szymek325/EngineeringDegree/README.md

# Engineering Degree project
Smart crontrol of temperature in room with Arduino and mobile app

## Modules:
### Mobile app- Ionic(AngularJS)
* temperature control
* display of historic data
* Bluetooth connection to regulator

### Regulator- Arduino
* temperature regulation accordingly to parameters set from Mobile App

### Documentation- LateX
