szymek325/EngineeringDegree/Documentation/Mateusz_Szymkowiak_Praca_Dyplomowa_Inzynierska.tex

\documentclass[11pt, a4paper,polish,twoside]{report}
\usepackage{graphicx}
\usepackage{times}
\usepackage[T1]{fontenc}
\usepackage[polish]{babel}
\usepackage[utf8]{inputenc}
\usepackage{lmodern}
\usepackage{hyperref}
\usepackage{graphicx}
\usepackage{pdfpages}
\usepackage{mathtools}
\selectlanguage{polish}
\usepackage{indentfirst}
\usepackage{gensymb}
\usepackage{rotating}
\widowpenalty=10000
\pagestyle {plain}
\usepackage{float}
\usepackage{geometry}
\usepackage{mathptmx}
\newgeometry{tmargin=2.5cm, bmargin=3.0cm, left=3.5cm, right=2.5cm}
\setcounter{secnumdepth}{2}
\linespread{1.3}
\usepackage{etoolbox}
\patchcmd{\chapter}{\thispagestyle{plain}}{\thispagestyle{fancy}}{}{}
\setlength{\headsep}{1.5cm}
\usepackage{listings}
\usepackage{lastpage}
\usepackage[MeX]{polski}
\graphicspath{ {./pictures/} }
\newcommand{\HRule}{\rule{\linewidth}{0.5mm}}
\usepackage{fancyhdr}
\pagestyle{fancy}
\setcounter{tocdepth}{1}
\usepackage[backend=bibtex]{biblatex}
\bibliography{bibliografia.bib}

\lstdefinelanguage{JavaScript}{
  keywords={typeof, new, true, false, catch, function, return, null, catch, switch, var, if, in, while, do, else, case, break},
  keywordstyle=\color{blue}\bfseries,
  ndkeywords={class, export, boolean, throw, implements, import, this},
  ndkeywordstyle=\color{darkgray}\bfseries,
  identifierstyle=\color{black},
  sensitive=false,
  comment=[l]{//},
  morecomment=[s]{/*}{*/},
  commentstyle=\color{purple}\ttfamily,
  stringstyle=\color{red}\ttfamily,
  morestring=[b]',
  morestring=[b]"
}

\begin{document}

%%%%%%%%%%%%%%%%%%%%%%%%		STRONA TYTUŁOWA

\input{sections/stronaTytulowa.tex}

%%%%%%%%%%%%%%%%%%%%%%%%		
\newpage
\null
\thispagestyle{empty}
\newpage
\includepdf[pages={1}]{./pictures/karta_pracy.pdf}

%%%%%%%%%%%%%%%%%%%%%%%%		STRESZCZENIE
\input{sections/streszczenie.tex}
%%%%%%%%%%%%%%%%%%%%%%%%		SPIS TREŚCI

\tableofcontents

%%%%%%%%%%%%%%%%%%%%%%%%	WSTĘP     \\\\\\\\\OK
\chapter{Wstęp}
\input{sections/wstep.tex}

%%%%%%%%%%%%%%%%%%%%%%%%	CEL I ZAKRES PRAC  \\\\\\OK
\chapter{Cel i zakres prac}
\input{sections/celiZakresPrac.tex}

%%%%%%%%%%%%%%%%%%%%%%%%	PODSTAWY TEORETYCZNE  \\\\\\OK
\chapter{Podstawy teoretyczne}
\input{sections/podstawyTeoretyczne.tex}

%%%%%%%%%%%%%%%%%%%%%%%%	Część konstrukcyjna  \\\\\\wygląda ok \\ZMIEN ZDJECIA
\chapter{Konstrukcja obiektu i układu regulacji}
\input{sections/czescKonstrukcyjna.tex}

%%%%%%%%%%%%%%%%%%%%%%%%	Arduino \\\w trakcie
\chapter{Sterowanie układem regulacji temperatury- Arduino}
\input{sections/arduino.tex}

%%%%%%%%%%%%%%%%%%%%%%%%	Aplikacja mobilna
\chapter{Aplikacja mobilna}
\input{sections/aplikacjaMobilna.tex}

%%%%%%%%%%%%%%%%%%%%%%%%	Testy działania
\chapter{Przeprowadzone testy}
\input{sections/regulacjaTemperatury.tex}

%%%%%%%%%%%%%%%%%%%%%%%%	Podsumowanie
\chapter{Podsumowanie}
\input{sections/podsumowanie.tex}

%%%%%%%%%%%%%%%%%%%%%%%%		BIBLIOGRAFIA
\addcontentsline{toc}{chapter}{Bibliografia}
%\input{sections/bibliografia.tex}

\nocite{*}
\printbibliography 

%%%%%%%%%%%%%%%%%%%%%%%%		Dodatki
\chapter*{Dodatki}
\addcontentsline{toc}{chapter}{Dodatki}
Dodatek do niniejszej pracy stanowi płyta CD zawierająca:
\begin{itemize}
\item pracę dyplomową w postaci źródłowej (LaTeX),
\item pracę dyplomową w postaci pliku pdf,
\item program napisany w Arduino IDE,
\item pliki źródłowe aplikacji mobilnej,
\item aplikację w postaci paczki dystrybucyjnej app.
\end{itemize}

\newpage
\addcontentsline{toc}{section}{Spis rysunków}	
\listoffigures

\newpage
\addcontentsline{toc}{section}{Spis tablic}	
\listoftables

%%%%%%%%%%%%%%%%%%%%%%%%

\end{document}
