szymek325/EngineeringDegree/Documentation/sections/bibliografia.tex

\newpage
\begin{thebibliography}{99}
\bibitem{1}
\emph{Arduino Playground},
http://playground.arduino.cc/
\bibitem{seb} ktos:
\emph{tytul},
Wydawnictwo , Poznań 2000
\end{thebibliography}
