szymek325/EngineeringDegree/Documentation/sections/streszczenie.tex

\vspace*{\fill}
\begin{center}
{\centering \Huge \bfseries Streszczenie}\\
\end{center}
W pracy zaprezentowano układ regulacji temperatury oparty o urządzenie mikroprocesorowe, Arduino. Jako obiekt chłodzący oraz grzejący użyto ogniwa Peltiera. Odczyt aktualnych pomiarów odbywa się przez interfejs dedykowanej aplikacji. Dane zostają wyświetlone na wykresach.  Aplikacja umożliwia wybór temperatury zadanej, regulatora oraz nastaw. Ze względu na użycie jedynie jednego ogniwa, temperaturę regulowano w obiekcie małych rozmiarów.
\\
\\
\\
\begin{center}
 {\Huge \bfseries  Abstract}\\
\end{center}
This work presents a temperature control system based on Arduino system. Peltier's cell was used as cooling and heating object. Actual readings can be read with use of dedicated mobile app. Data is visualised on graphs. Application allows user to choose setpoint temperature, regulator and regulator settings. Due to use of only one cell, the temperature was controlled in object of small size.
\\
\\
\\
\\
\\
\\
\\
\\
\\
\vspace*{\fill}
