szymek325/EngineeringDegree/Documentation/sections/stronaTytulowa.tex

\begin{titlepage}
	\begin{center}
		\textsc{\LARGE Politechnika Poznańska}\\[0.3cm] 
		\textsc{\large Wydział Elektryczny}\\[0.3cm]
		\textsc{\large Instytut Automatyki i Inżynierii Informatycznej}\\[0.3cm]
		\textsc{\large Zakład Sterowania i Elektroniki Przemysłowej}\\[0.3cm]
		\begin{figure}[!ht]
		\centering
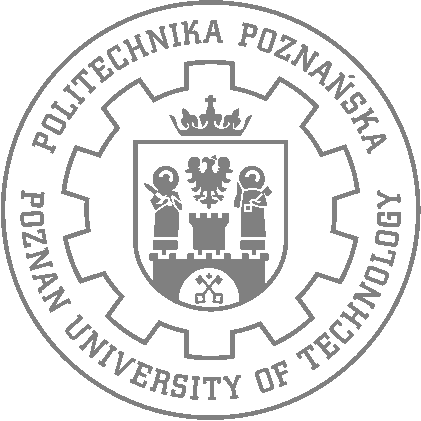
[picture p25: Documentation/pictures/logoPP.png]
		
		\end{figure}
		\textsc{\Large Praca inżynierska}\\[0.5cm]
		\HRule \\[0.4cm]
		{ \huge  Sterowanie wybranym procesem technologicznym za pomocą układu mikroprocesorowego\\[0.4cm] }
		\HRule \\[2.5cm]
		\noindent
		\begin{minipage}{0.4\textwidth}
			\begin{flushleft} 
				\large \emph{Autor:}\\ Mateusz Szymkowiak
			\end{flushleft}
		\end{minipage}%
		\begin{minipage}{0.4\textwidth}
			\begin{flushright} \large
				\emph{Promotor:} \\ \hfill dr hab. inż. 
				\\Tomasz Pajchrowski
				
			\end{flushright}
		\end{minipage}
		
		\vfill
		
		% Bottom of the page
		{\large \today}

	\end{center}

\end{titlepage}

\lhead{\scriptsize \textsc{Praca dyplomowa pt. ,,Sterowanie wybranym procesem technologicznym za pomocą układu mikroprocesorowego''\\
		Politechnika Poznańska, Instytut automatyki i inżynierii informatycznej\\
		Zakład Sterowania i Elektroniki Przemysłowej}}
\rhead{{\thepage{} z \pageref{LastPage}}}
