szymek325/EngineeringDegree/Documentation/sections/konfiguracja.tex

\section{Układ pomiarowo-wykonawczy}
W tym dziale przedstawiono 
\begin{figure}[H]
	\centering
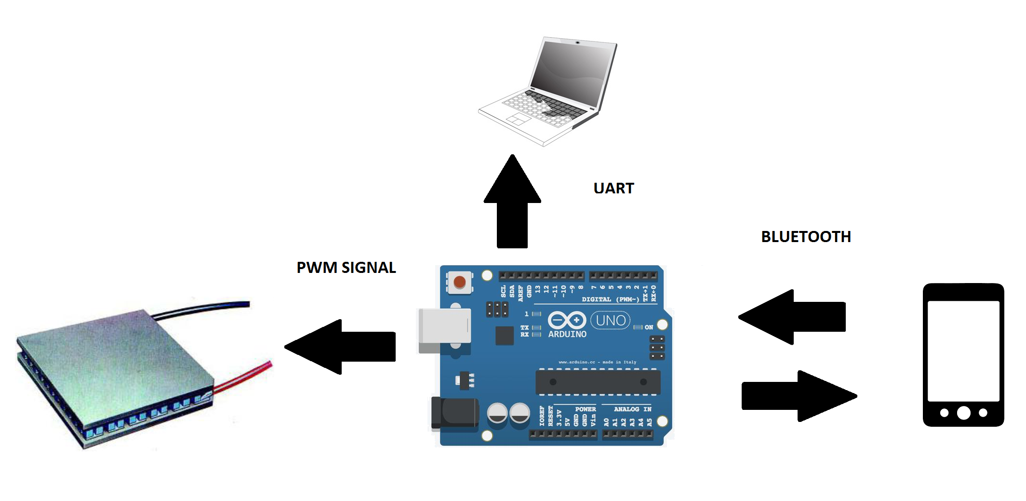
[picture p26: Documentation/pictures/schemat_komunikacji.png]
	
	\caption{Schemat połączeń komunikacyjnych}
\end{figure}
