szymek325/EngineeringDegree/Documentation/pictures/Bluetooth_ramka.png

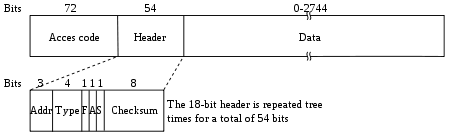
Documentation/pictures/Bluetooth_ramka.png
