szymek325/EngineeringDegree/Documentation/pictures/ogniwoPolaczenieRzeczywiste.jpg

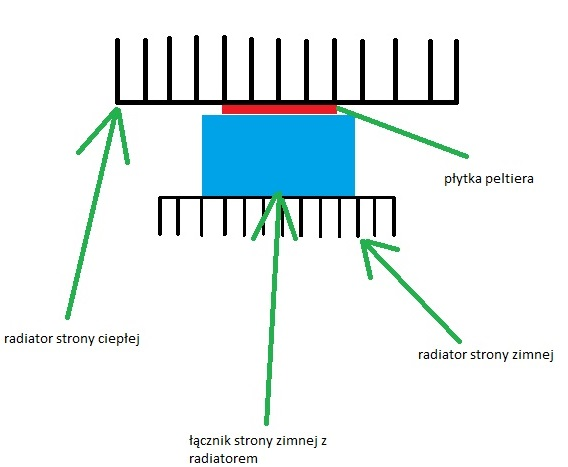
Documentation/pictures/ogniwoPolaczenieRzeczywiste.jpg
