szymek325/EngineeringDegree/Documentation/pictures/plytkaPolaczenia.jpg

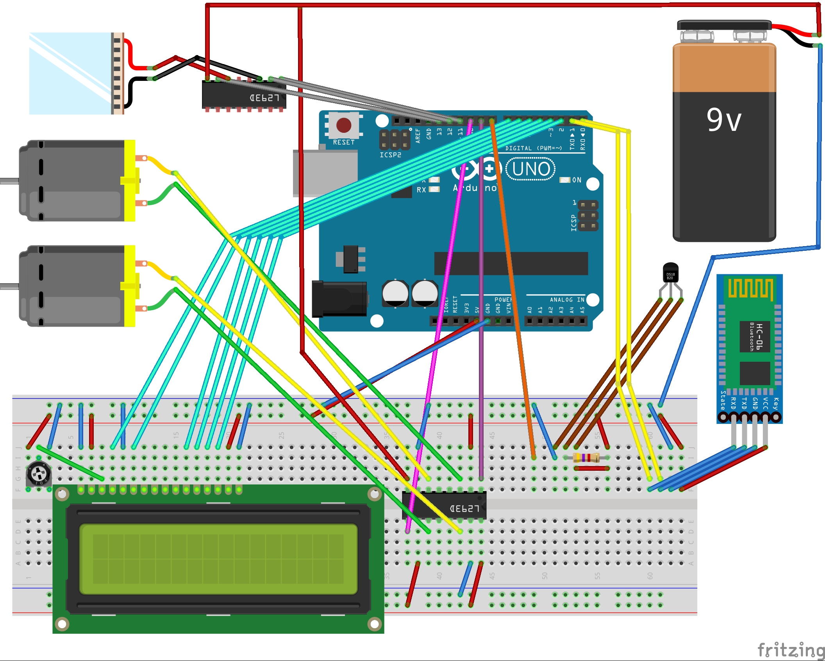
Documentation/pictures/plytkaPolaczenia.jpg
