szymek325/EngineeringDegree/Documentation/pictures/schemat_dzialania — kopia.png

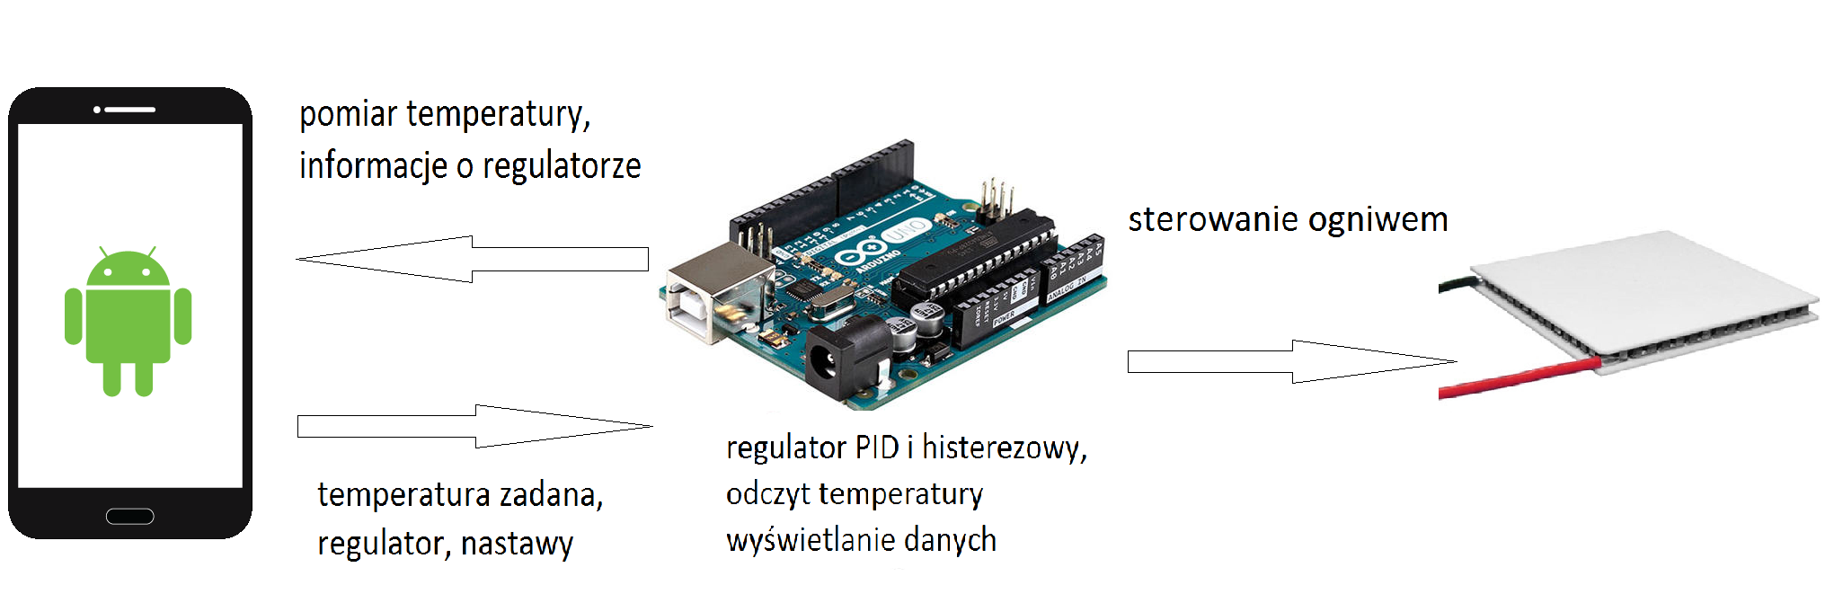
Documentation/pictures/schemat_dzialania — kopia.png
