szymek325/EngineeringDegree/Documentation/pictures/schematElektryczny.jpg

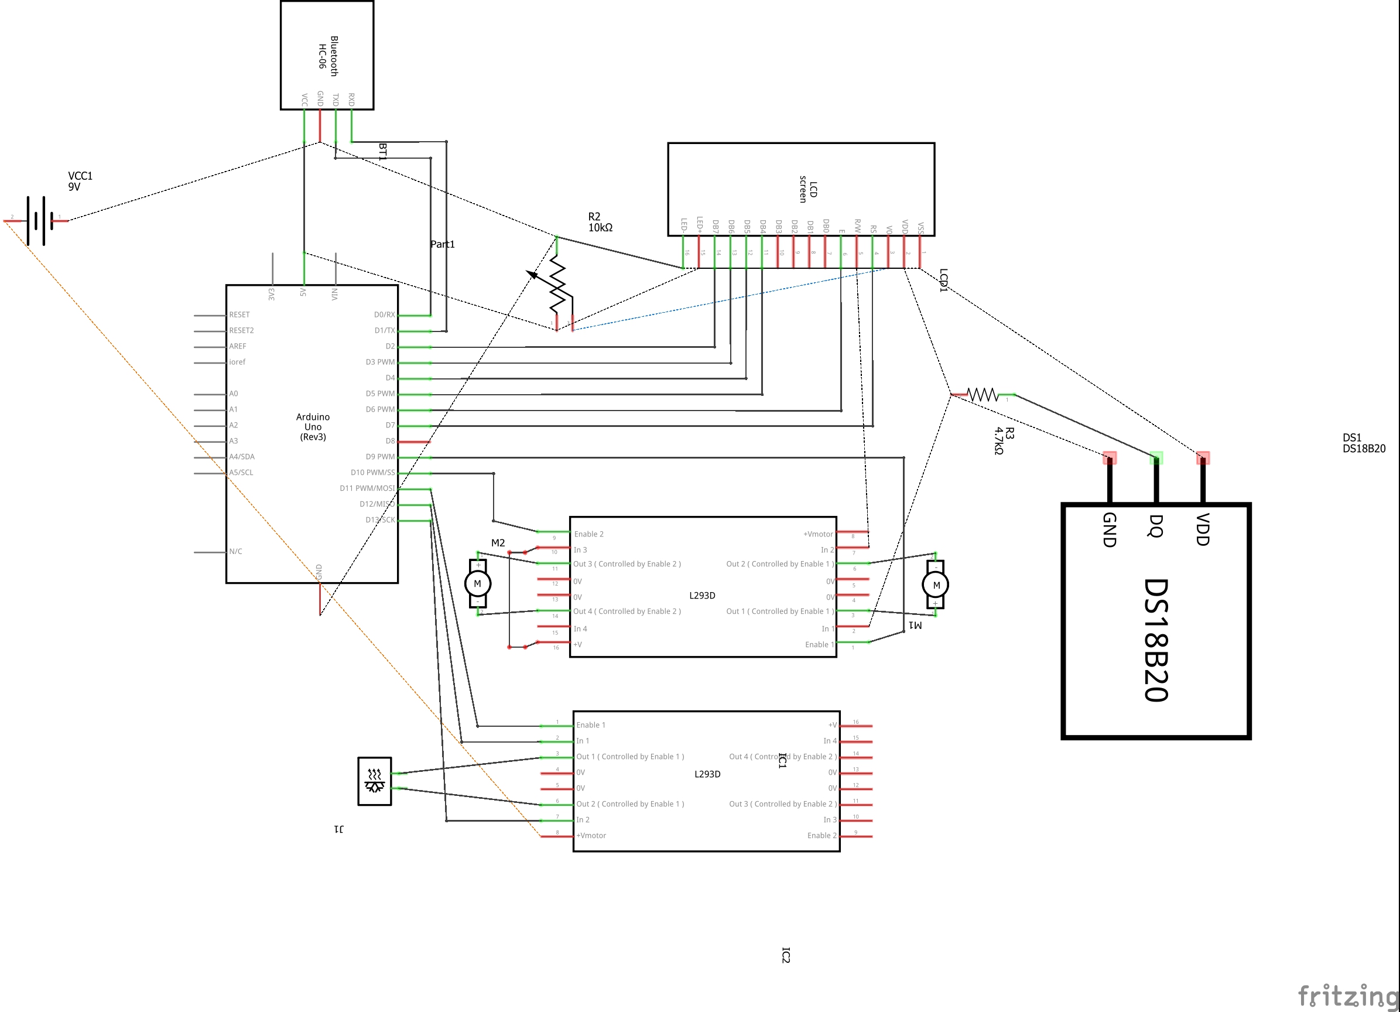
Documentation/pictures/schematElektryczny.jpg
