szymek325/EngineeringDegree/Documentation/pictures/test_chlodzenia-eps-converted-to.pdf

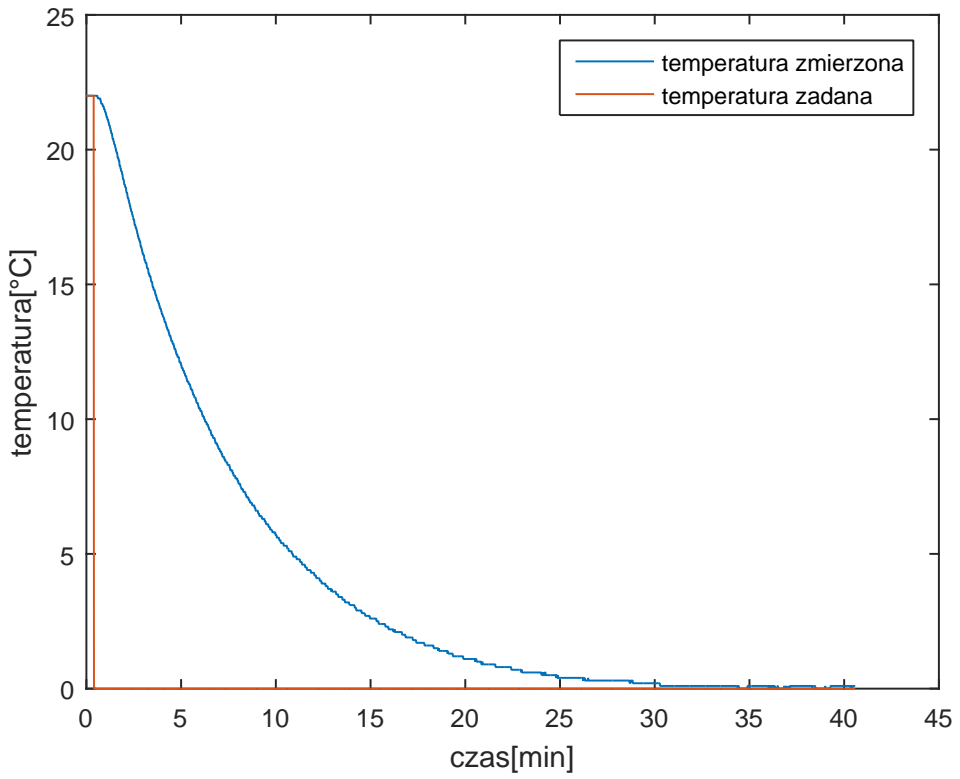
[picture p36: page 1]
czas[min]; temperatura[°C]; temperatura zmierzona temperatura zadana
