szymek325/EngineeringDegree/Documentation/pictures/26kp100-eps-converted-to.pdf

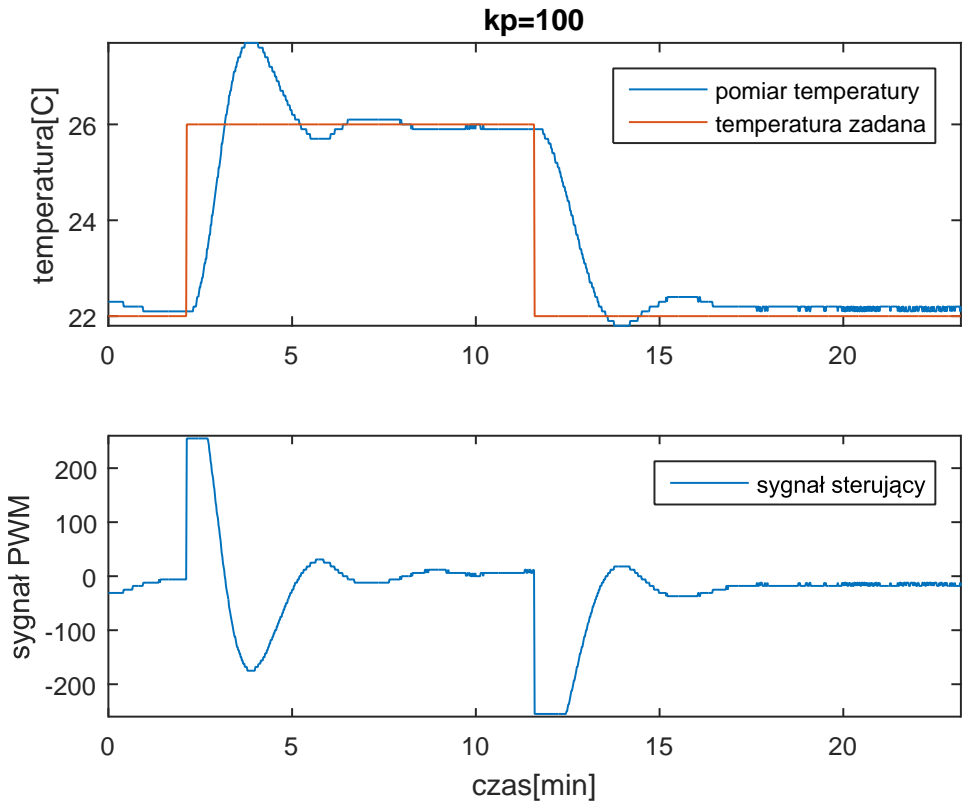
[picture p37: page 1]
temperatura[C]; pomiar temperatury temperatura zadana; czas[min]
