szymek325/EngineeringDegree/Documentation/pictures/26kp200-eps-converted-to.pdf

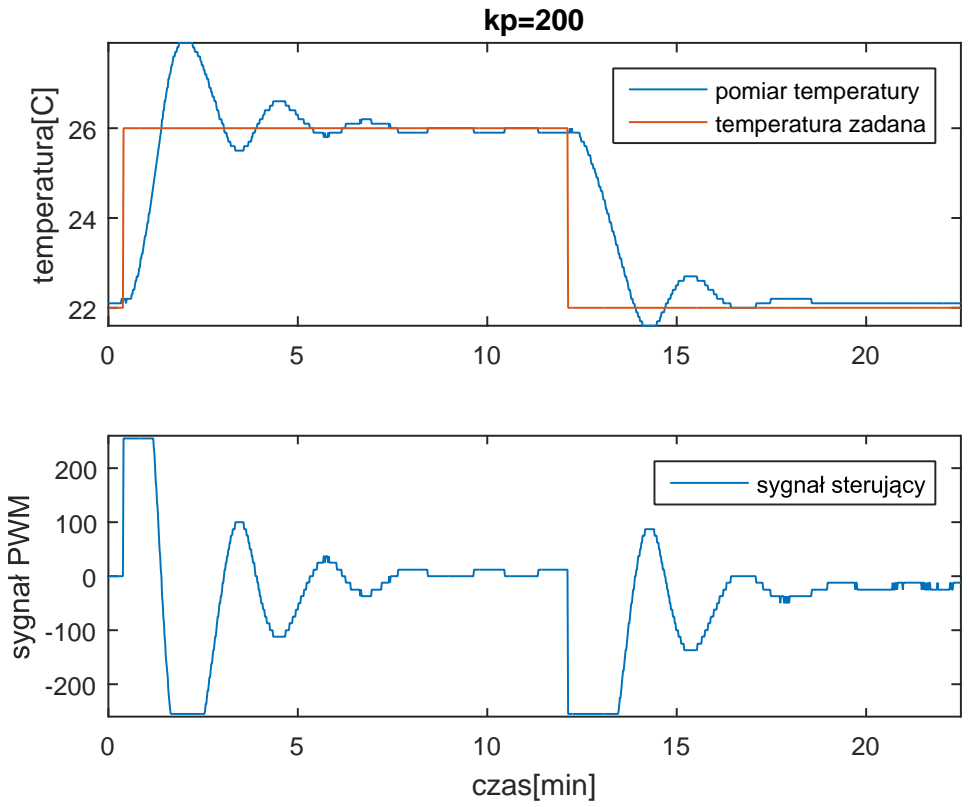
[picture p38: page 1]
temperatura[C]; pomiar temperatury temperatura zadana; czas[min]
