szymek325/EngineeringDegree/Documentation/pictures/26kp25-eps-converted-to.pdf

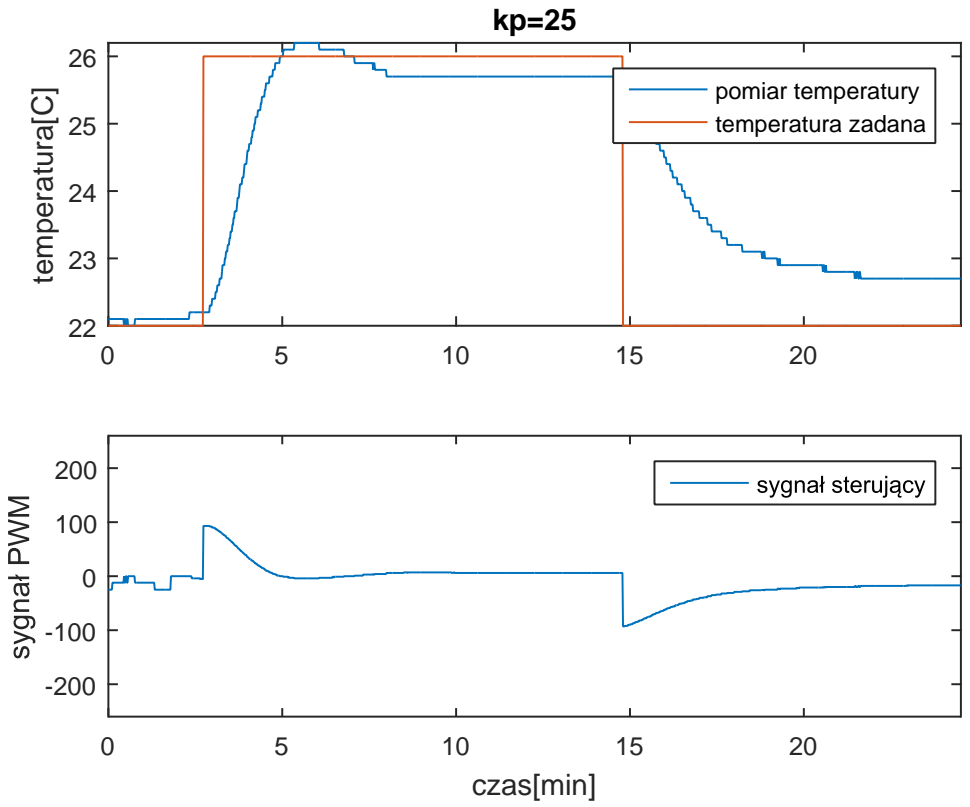
[picture p39: page 1]
temperatura[C]; pomiar temperatury temperatura zadana; czas[min]
