szymek325/EngineeringDegree/Documentation/pictures/26kp250kd20-eps-converted-to.pdf

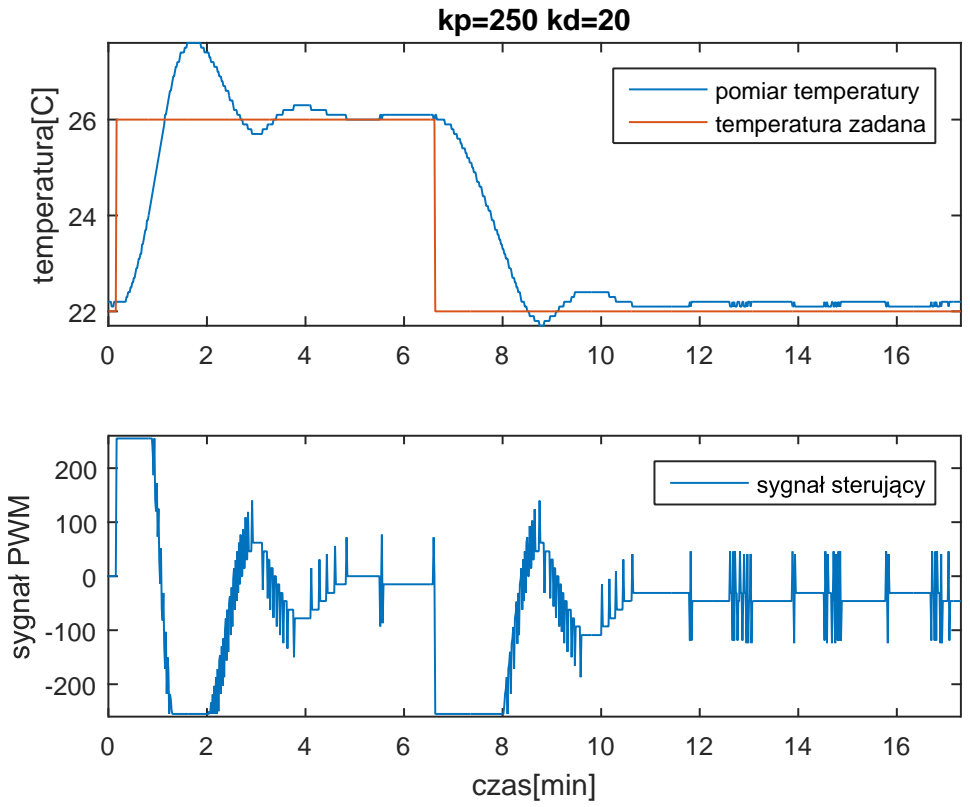
[picture p40: page 1]
temperatura[C]; pomiar temperatury temperatura zadana; czas[min]
