szymek325/EngineeringDegree/Documentation/pictures/26kp250kd40-eps-converted-to.pdf

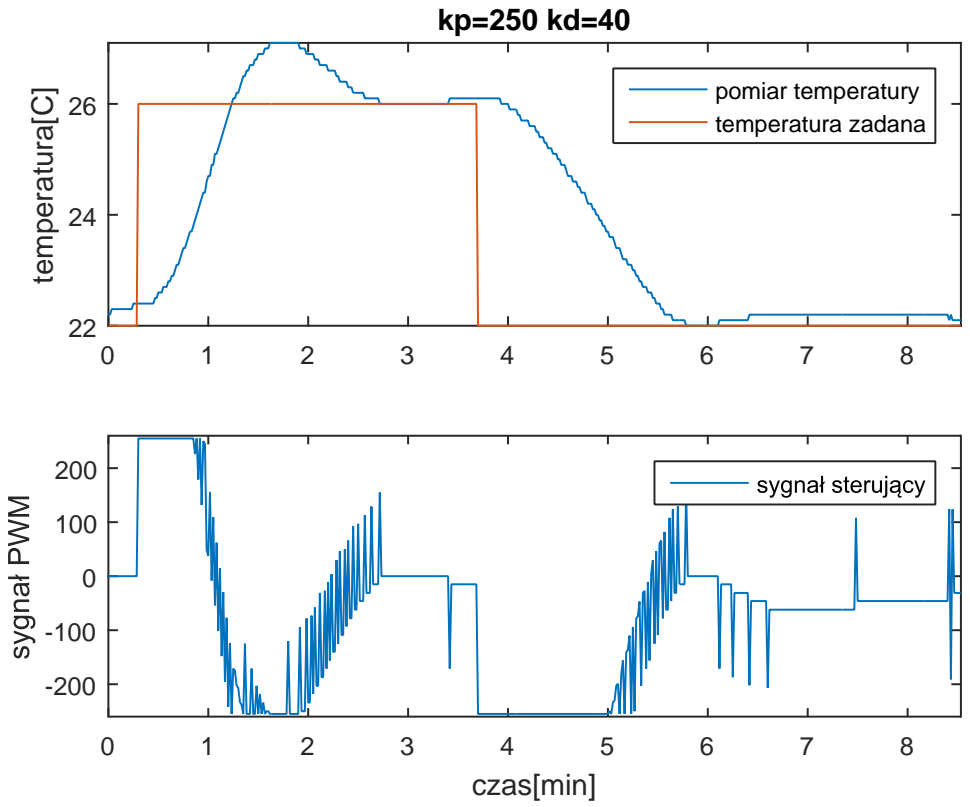
[picture p41: page 1]
temperatura[C]; pomiar temperatury temperatura zadana; czas[min]
