szymek325/EngineeringDegree/Documentation/pictures/26kp250kd80-eps-converted-to.pdf

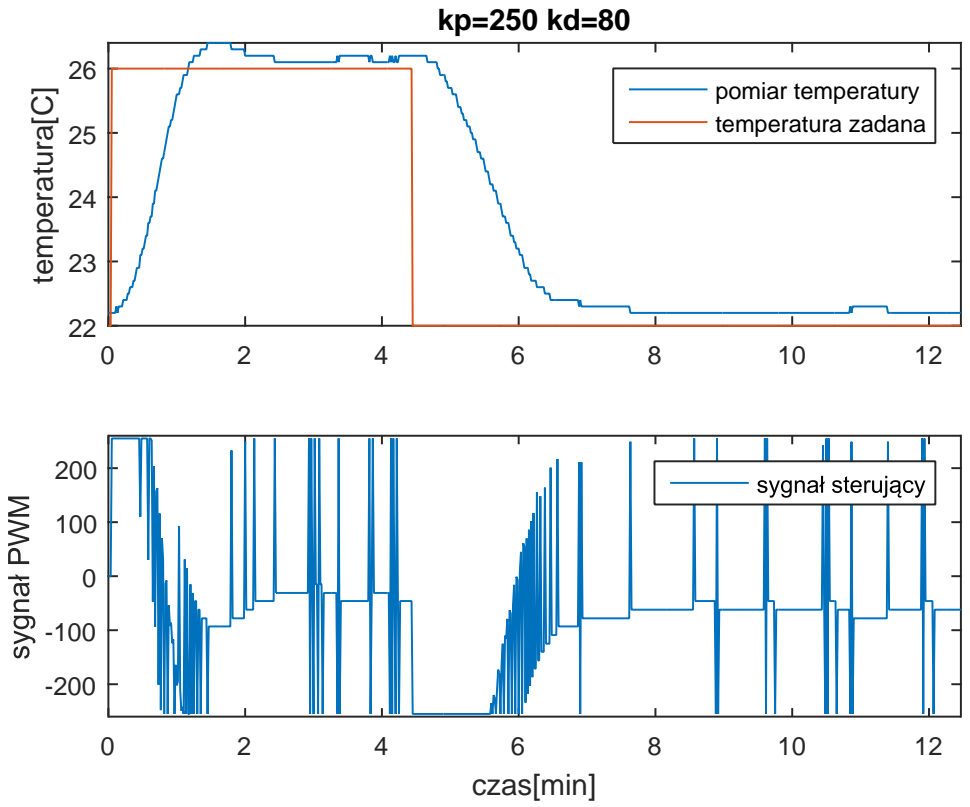
[picture p42: page 1]
temperatura[C]; pomiar temperatury temperatura zadana; czas[min]
