szymek325/EngineeringDegree/Documentation/pictures/26kp250ki35kd50-eps-converted-to.pdf

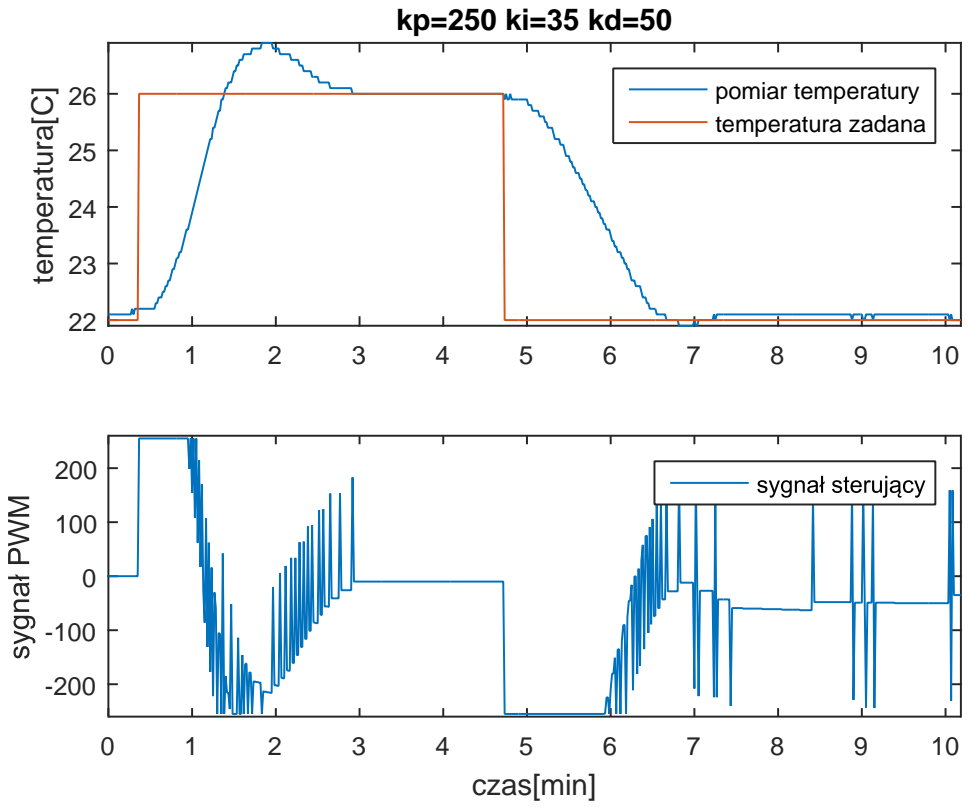
[picture p43: page 1]
temperatura[C]; pomiar temperatury temperatura zadana; czas[min]
