szymek325/EngineeringDegree/Documentation/pictures/26kp250ki50kd60-eps-converted-to.pdf

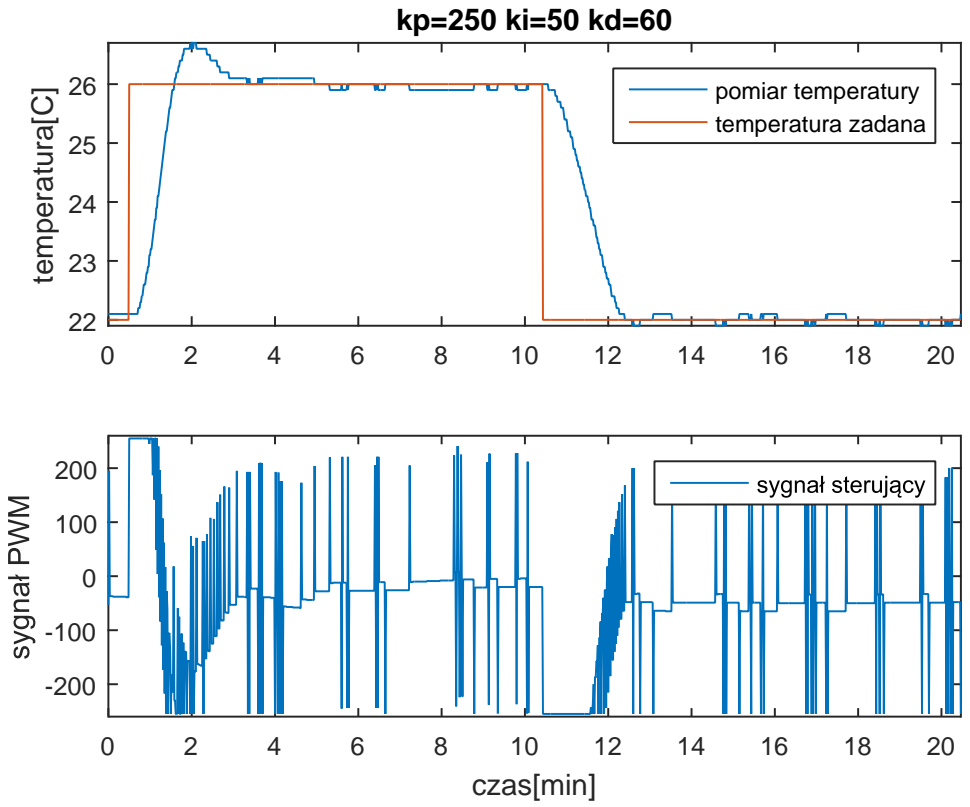
[picture p44: page 1]
temperatura[C]; pomiar temperatury temperatura zadana; czas[min]
