szymek325/EngineeringDegree/Documentation/pictures/26kp50-eps-converted-to.pdf

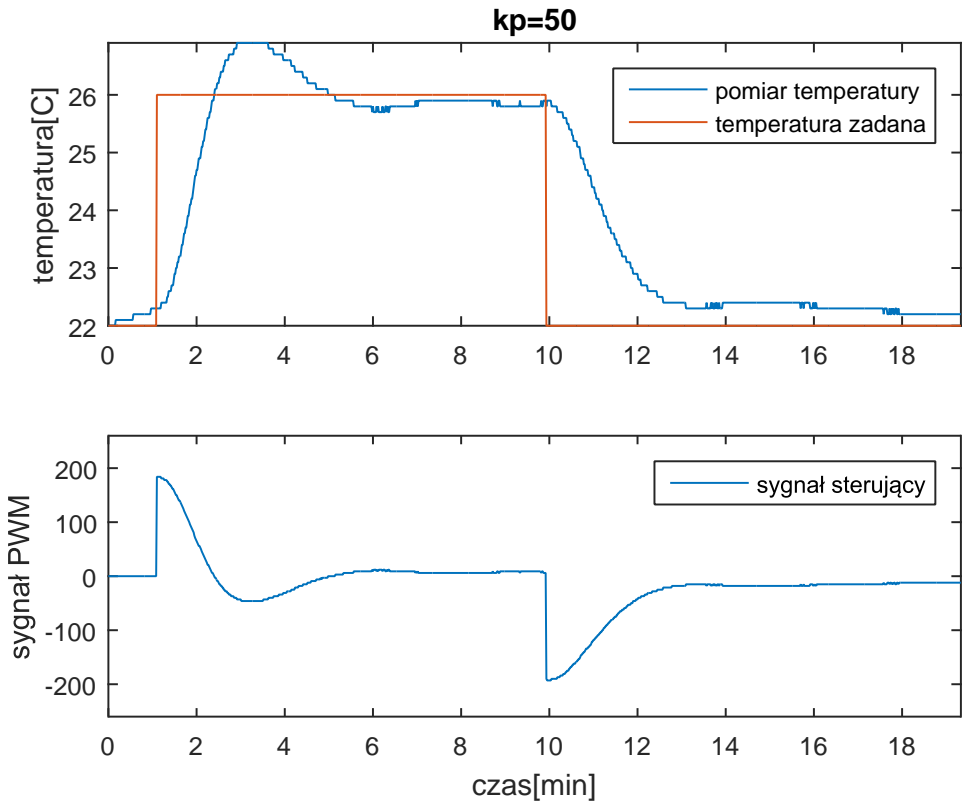
[picture p45: page 1]
temperatura[C]; pomiar temperatury temperatura zadana; czas[min]
