szymek325/EngineeringDegree/Documentation/pictures/26kp50ki15-eps-converted-to.pdf

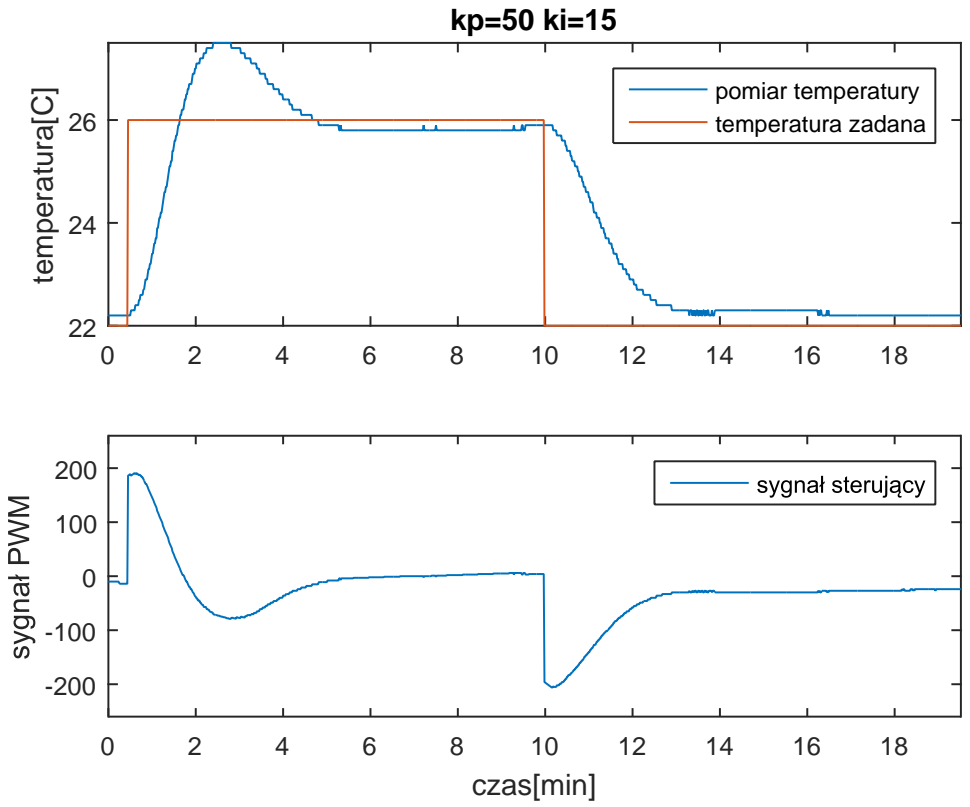
[picture p46: page 1]
temperatura[C]; pomiar temperatury temperatura zadana; czas[min]
