szymek325/EngineeringDegree/Documentation/pictures/26kp50ki30-eps-converted-to.pdf

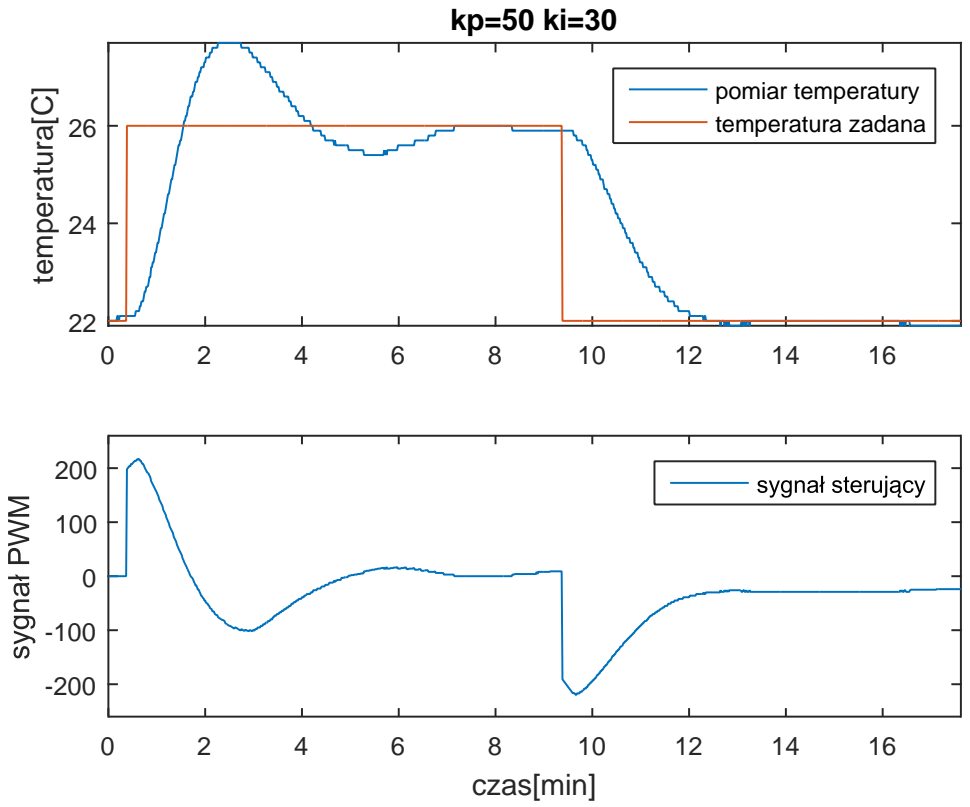
[picture p47: page 1]
temperatura[C]; pomiar temperatury temperatura zadana; czas[min]
