szymek325/EngineeringDegree/Documentation/pictures/26kp50ki60-eps-converted-to.pdf

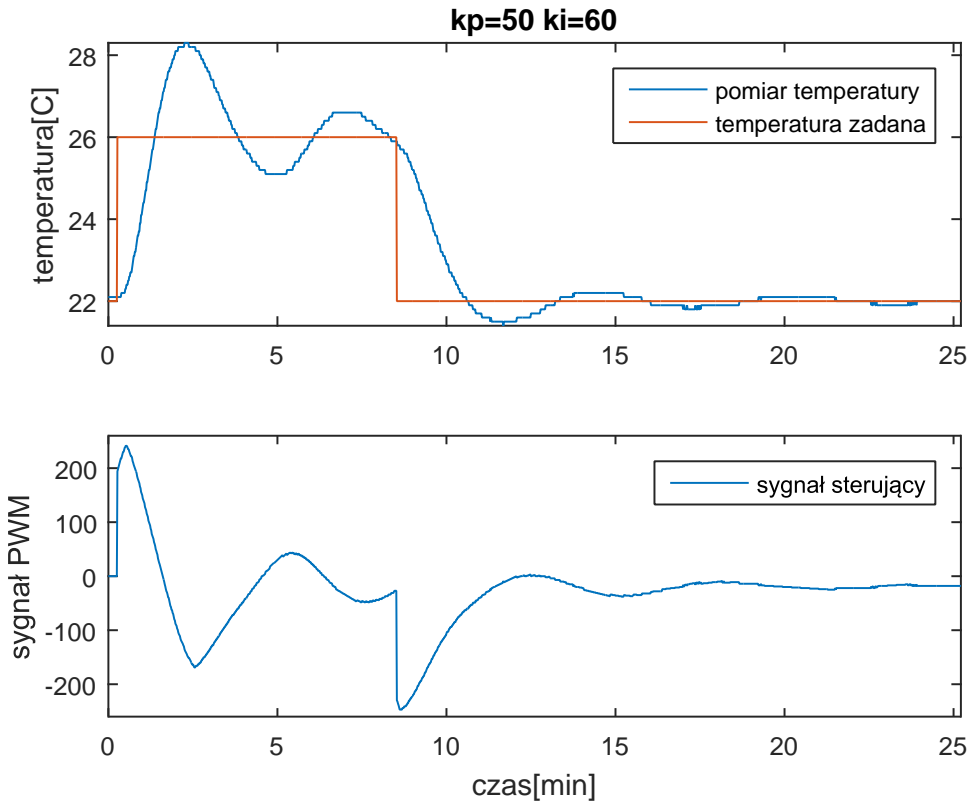
[picture p48: page 1]
temperatura[C]; pomiar temperatury temperatura zadana; czas[min]
