szymek325/EngineeringDegree/Documentation/pictures/chlodzenie-eps-converted-to.pdf

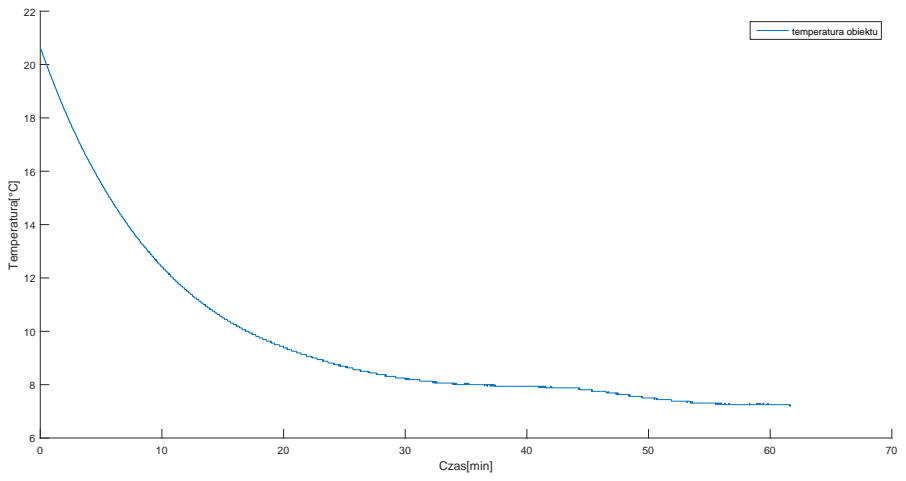
[picture p49: page 1]
Czas[min]; Temperatura[°C]; temperatura obiektu
