szymek325/EngineeringDegree/Documentation/pictures/grzanie-eps-converted-to.pdf

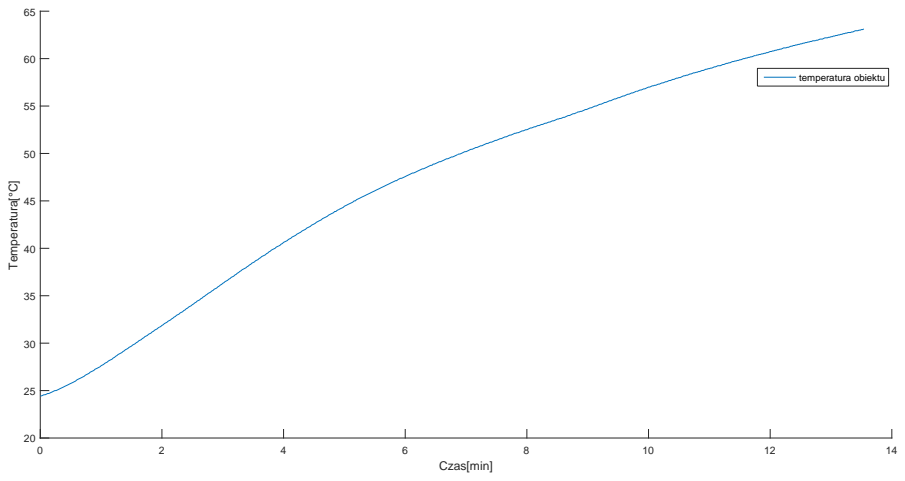
[picture p50: page 1]
Czas[min]; Temperatura[°C]; temperatura obiektu
