szymek325/EngineeringDegree/Documentation/pictures/hist18-eps-converted-to.pdf

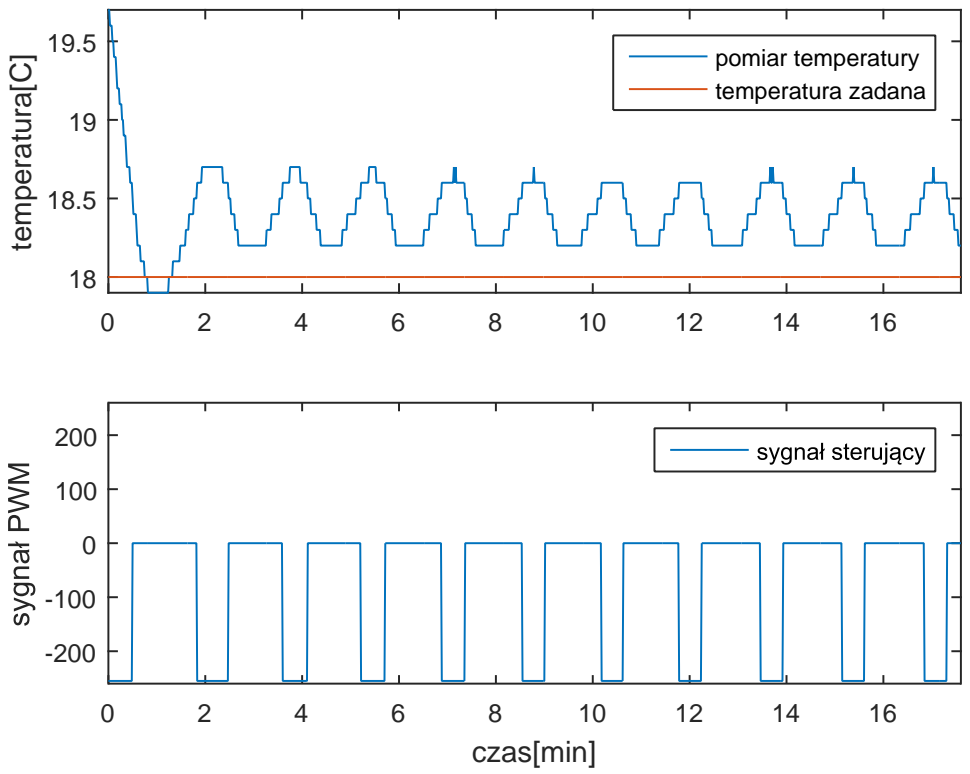
[picture p51: page 1]
temperatura[C]; pomiar temperatury; temperatura zadana; czas[min]
