szymek325/EngineeringDegree/Documentation/pictures/hist26-eps-converted-to.pdf

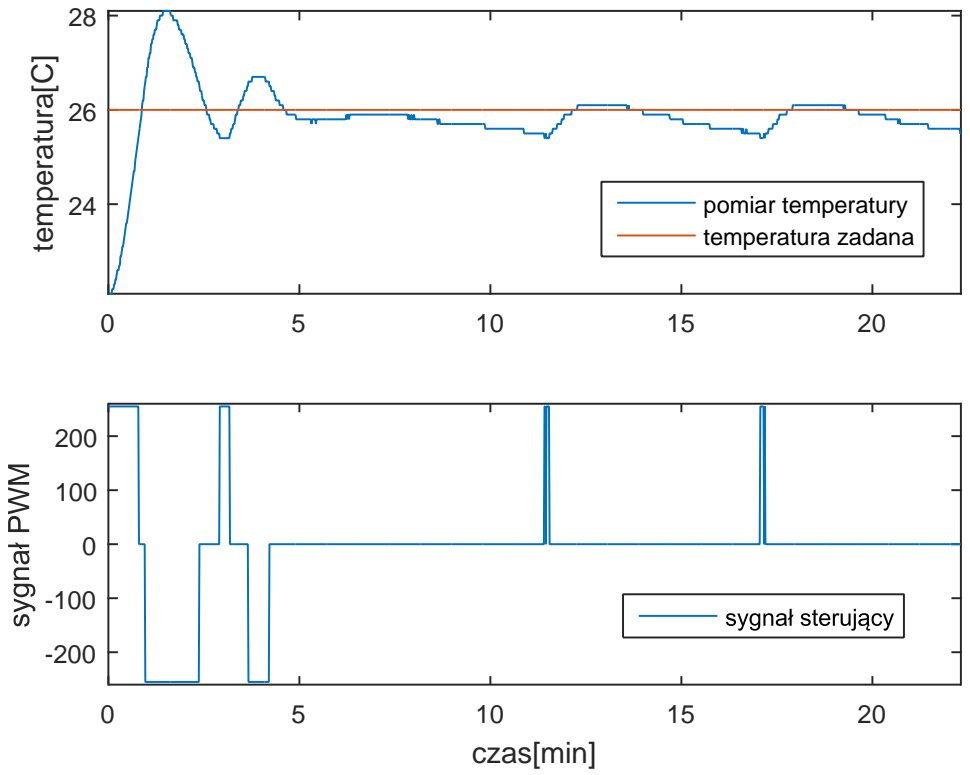
[picture p52: page 1]
temperatura[C]; pomiar temperatury temperatura zadana; czas[min]
