szymek325/EngineeringDegree/Documentation/pictures/pid18-eps-converted-to.pdf

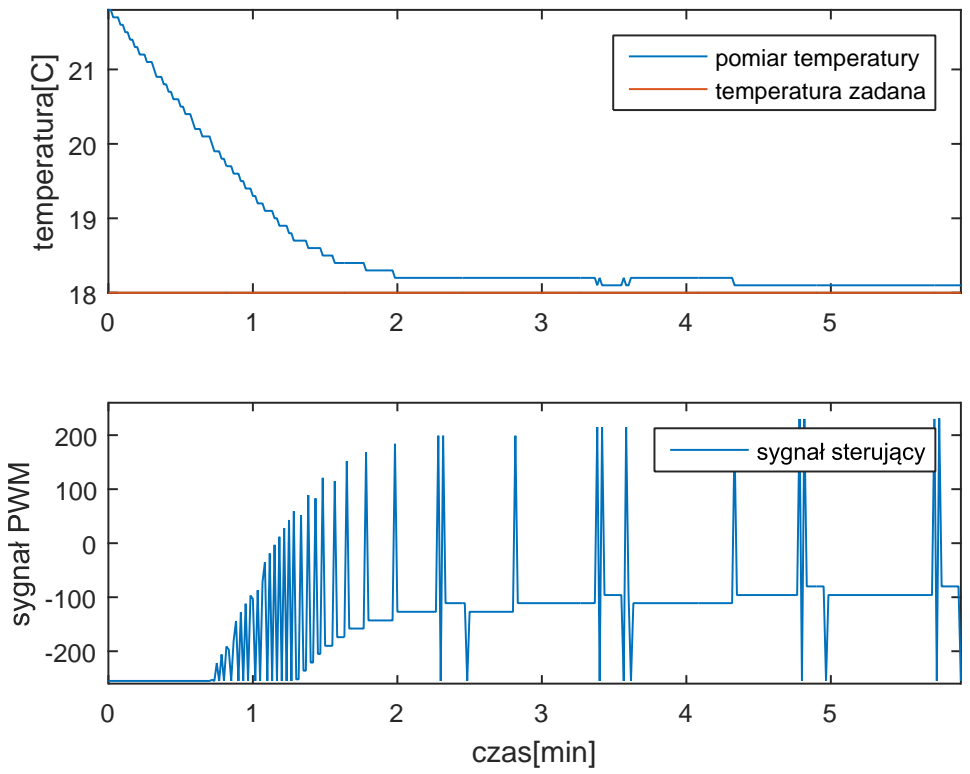
[picture p53: page 1]
temperatura[C]; pomiar temperatury; temperatura zadana; czas[min]
