szymek325/EngineeringDegree/Documentation/pictures/pid25-eps-converted-to.pdf

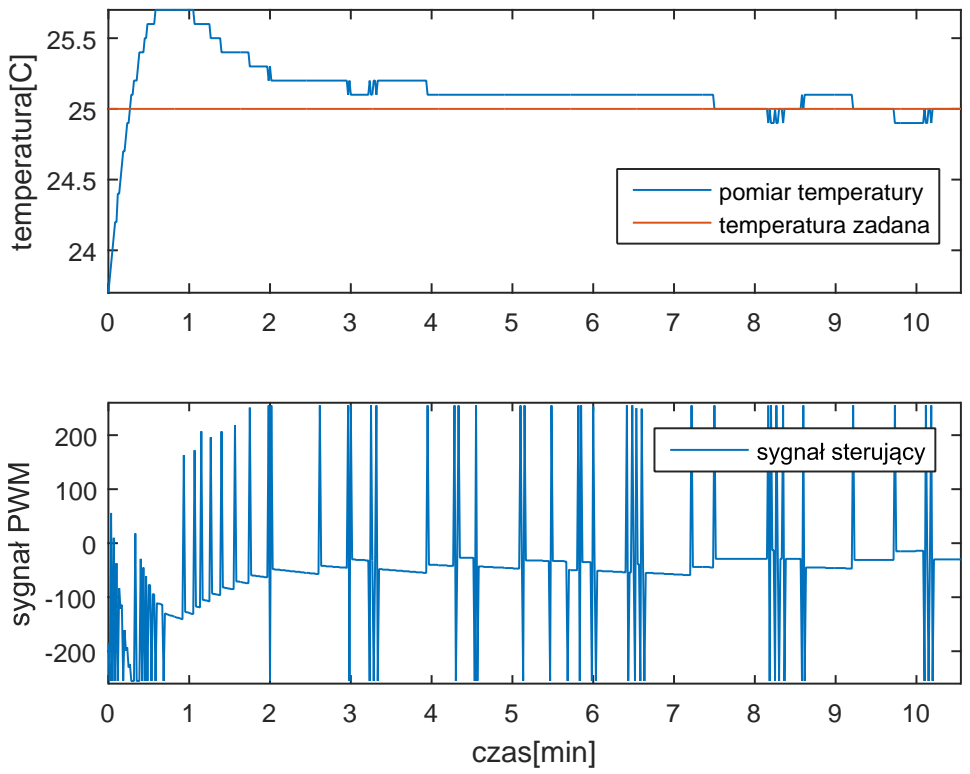
[picture p54: page 1]
temperatura[C]; pomiar temperatury temperatura zadana; czas[min]
