szymek325/EngineeringDegree/Documentation/pictures/pid30-eps-converted-to.pdf

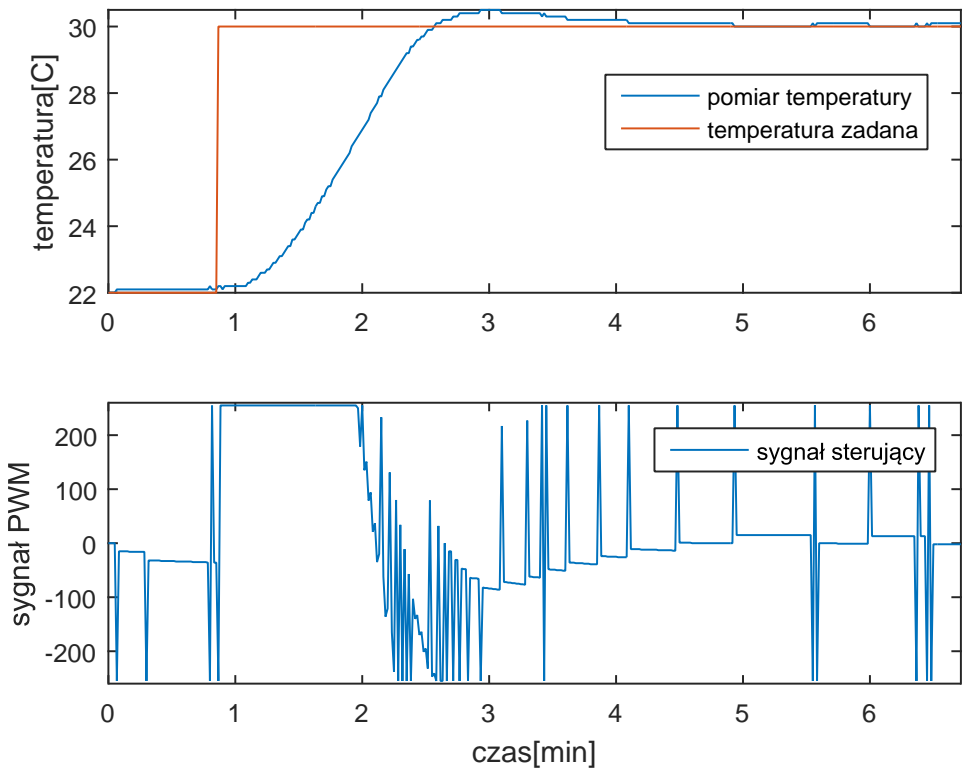
[picture p55: page 1]
temperatura[C]; pomiar temperatury temperatura zadana; czas[min]
