szymek325/EngineeringDegree/Documentation/pictures/regulacja25-eps-converted-to.pdf

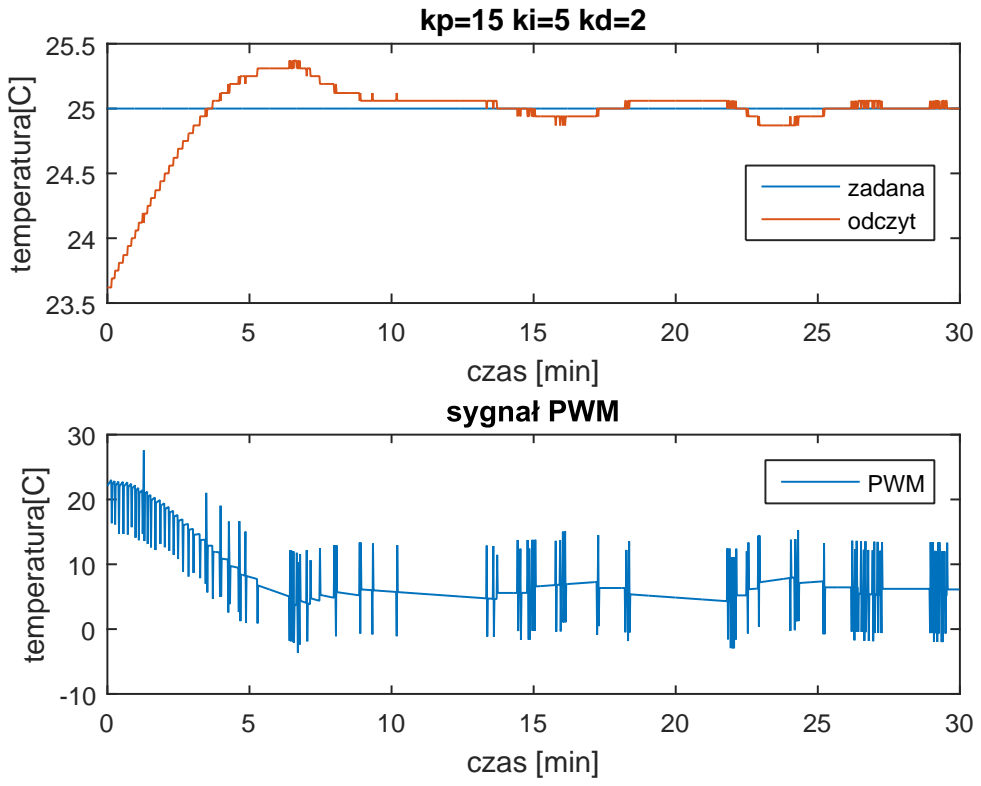
[picture p56: page 1]
czas [min]; temperatura[C]; zadana odczyt; PWM
