szymek325/EngineeringDegree/Documentation/pictures/regulatorP-eps-converted-to.pdf

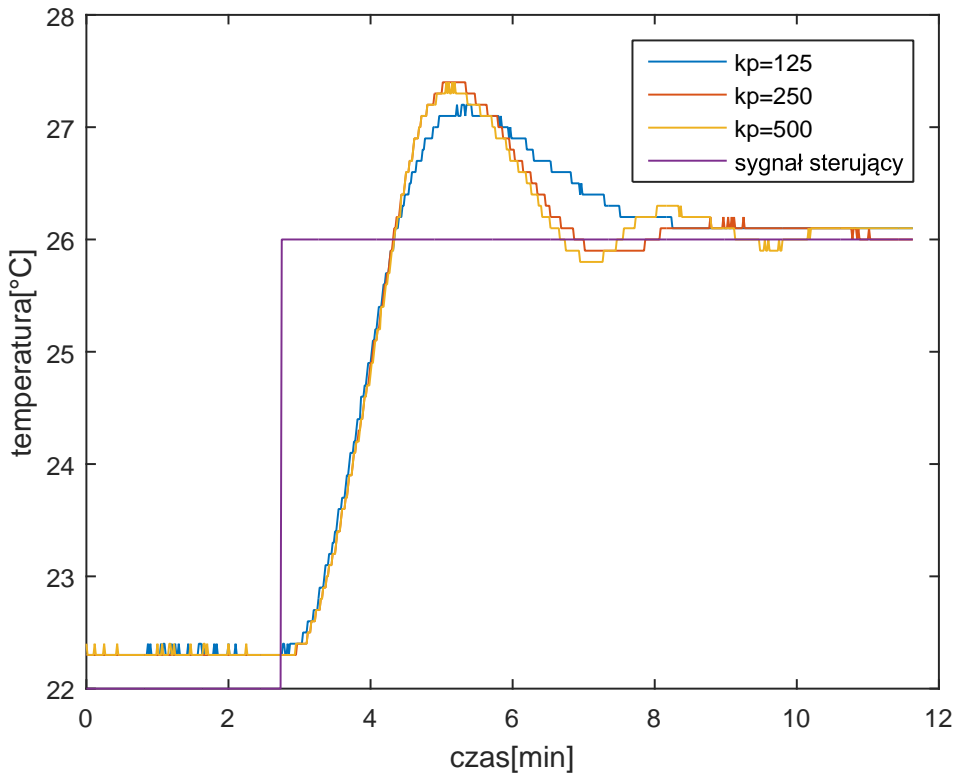
[picture p57: page 1]
czas[min]; temperatura[°C]
