szymek325/EngineeringDegree/(commit log)

2016-12-06 PID
    PID regulator + things
2016-12-20 bl005
    working device list
2016-12-22 app001bl007
    +new look, backup, working bluetooth, better searching devices
    -Light Control needs improvement
    -should add bluetooth for other things
    -add graphs
2016-12-25 bluetooth
    +bluetooth Send/Receive
    +Timers
2017-01-01 erase_errors
    erased pwm errors
    [projekt_arduino.ino]
2017-01-01 bl014
    deleted 'start receiving' button etc
2017-01-05 final3
    stop updating button
2017-01-06 final6
    connection buttons are working great now!
2017-01-06 final3
    some pwm problems
    [projekt_arduino.ino]
2018-04-01 documentation
    completed engineering documentation
    [schemat.kicad_pcb, schemat.sch]
2019-06-28 documentation moved to folder
    [schemat.kicad_pcb, schemat.sch]
2019-06-28 arduino moved to folder
